bradgrantham/alice3cv/ColecoHat2/kicad/ColecoHat2.kicad_pcb

## KiCad design ColecoHat2/kicad/ColecoHat2.kicad_pcb (2018-12-31)

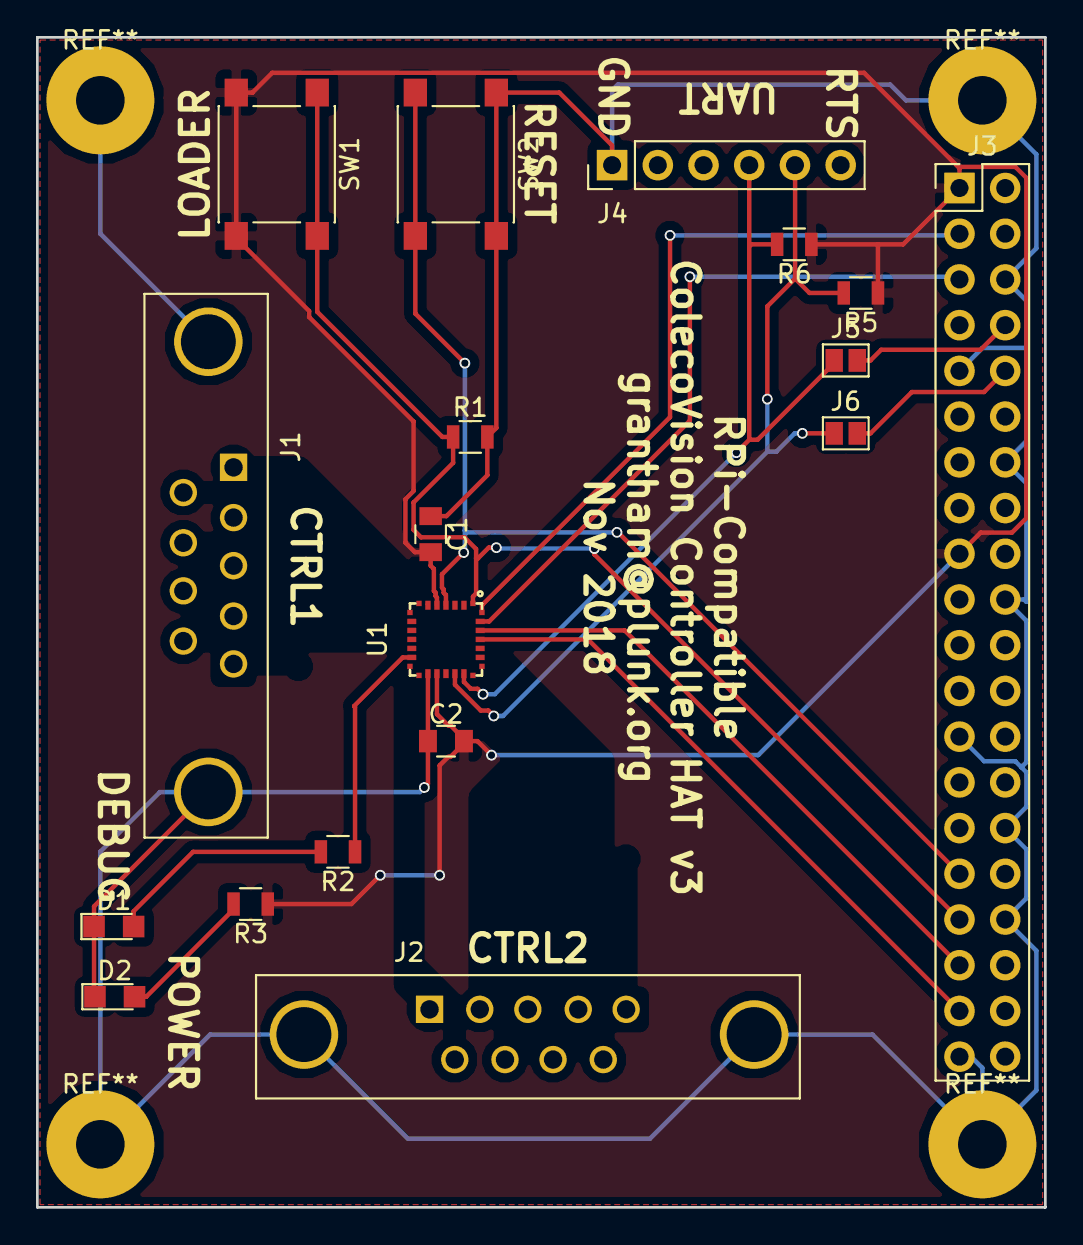
[picture p1: board ColecoHat2.kicad_pcb from above]

Board: 2 copper layers, 56.0 x 65.0 mm, 18 parts (0 on the bottom side), 31 nets.

Parts:
C1, C2: 100nF; C_0805
D1: DEBUG; LED_0805
D2: POWER; LED_0805
J1: CTRL1; DB9MD
J2: CTRL2; DB9MD
J3: PI_HEADER; Pin_Header_Straight_2x20_Pitch2.54mm
J4: CONN_01X06; Pin_Header_Straight_1x06_Pitch2.54mm
J5, J6: GS2
R1: 10k; R_0805
R2: 470; R_0805
R3: 1K; R_0805
R5, R6: 100k; R_0805
SW1: BOOTLOADER; SW_SPST_PTS645
SW2: RESET; SW_SPST_PTS645
U1: STM32L011G4U6; UFQFPN-28

Connections:
+3V3: C1.2, C2.2, J3.1, J3.17, R3.1, R5.1, R6.1, SW1.2, U1.5, U1.17
BOOTLOADER: J3.33, R1.1, SW1.1, U1.1
DEBUG_GPIO: J3.37, U1.25
DEBUG_LED: R2.1, U1.13
E1: J1.4, U1.11
E2: J2.4, U1.23
FIRE1: J1.6, U1.7
FIRE2: J2.6, U1.15
GND: C1.1, C2.1, D1.1, D2.1, J1.0, J2.0, J3.6, J3.9, J3.14, J3.20, J3.25, J3.30, J3.34, J3.39, J4.1, R1.2, SW2.1, U1.16
I2C1_SCL: J3.5, U1.27
I2C1_SDA: J3.3, U1.28
IRQ: J3.35, U1.26
N1: J1.1, U1.6
N2: J2.1, U1.14
NRST: J3.31, SW2.2, U1.4
unnamed: D1.2, R2.2
unnamed: D2.2, R3.2
unnamed: J3.8, J5.2
unnamed: J3.10, J6.2
QUADA1: J1.7, U1.9
QUADA2: J2.7, U1.21
QUADB1: J1.9, U1.12
QUADB2: J2.9, U1.24
S1: J1.2, U1.8
S2: J2.2, U1.18
SELECT_JOYSTICK: J1.8, J2.8, U1.2
SELECT_KEYPAD: J1.5, J2.5, U1.3
USART1_RX: J4.4, J5.1, R6.2, U1.20
USART1_TX: J4.5, J6.1, R5.2, U1.19
W1: J1.3, U1.10
W2: J2.3, U1.22
