bradgrantham/alice3cv/ColecoHat2/firmware/uart.c

#include <stm32l0xx_hal.h>
#include "defs.h"
#include "uart.h"
#include "stm32l0xx_ll_bus.h"
#include "stm32l0xx_ll_rcc.h"
// #include "stm32l0xx_ll_system.h"
// #include "stm32l0xx_ll_utils.h"
// #include "stm32l0xx_ll_cortex.h"
// #include "stm32l0xx_ll_exti.h"
//#include "stm32l0xx_ll_pwr.h"
#include "stm32l0xx_ll_gpio.h"
#include "stm32l0xx_ll_usart.h"

/*--------------------------------------------------------------------------*/
/* USART - serial comms ----------------------------------------------------*/

void SERIAL_send_one_char(char c)
{
    /* Wait for TXE flag to be raised */
    while (!LL_USART_IsActiveFlag_TXE(USART2));

    LL_USART_ClearFlag_TC(USART2); 

    /* Write character in Transmit Data register.
       TXE flag is cleared by writing data in TDR register */
    LL_USART_TransmitData8(USART2, c);

    /* Wait for TC flag to be raised for last char */
    while (!LL_USART_IsActiveFlag_TC(USART2));
}

void HAL_UART_ErrorCallback(UART_HandleTypeDef *huart)
{
    panic();
}

/**
  * @brief  This function configures USART2 Instance.
  * @note   This function is used to :
  *         -1- Enable GPIO clock and configures the USART pins.
  *         -2- Enable the USART peripheral clock and clock source.
  *         -3- Configure USART functional parameters.
  *         -4- Enable USART.
  * @note   Peripheral configuration is minimal configuration from reset values.
  *         Thus, some useless LL unitary functions calls below are provided as
  *         commented examples - setting is default configuration from reset.
  * @param  None
  * @retval None
  */
void SERIAL_init(void)
{
  /* (1) Enable GPIO clock and configures the USART pins *********************/

  /* Enable the peripheral clock of GPIO Port */
  LL_IOP_GRP1_EnableClock(LL_IOP_GRP1_PERIPH_GPIOA);

  /* Configure Tx Pin as : Alternate function, High Speed, Push pull, Pull up */
  LL_GPIO_SetPinMode(GPIOA, GPIO_PIN_9, LL_GPIO_MODE_ALTERNATE);
  LL_GPIO_SetAFPin_8_15(GPIOA, LL_GPIO_PIN_9, LL_GPIO_AF_4);
  LL_GPIO_SetPinSpeed(GPIOA, GPIO_PIN_9, LL_GPIO_SPEED_FREQ_HIGH);
  LL_GPIO_SetPinOutputType(GPIOA, GPIO_PIN_9, LL_GPIO_OUTPUT_PUSHPULL);
  LL_GPIO_SetPinPull(GPIOA, GPIO_PIN_9, LL_GPIO_PULL_UP);

  /* Configure Rx Pin as : Alternate function, High Speed, Push pull, Pull up */
  LL_GPIO_SetPinMode(GPIOA, GPIO_PIN_10, LL_GPIO_MODE_ALTERNATE);
  LL_GPIO_SetAFPin_8_15(GPIOA, LL_GPIO_PIN_10, LL_GPIO_AF_4);
  LL_GPIO_SetPinSpeed(GPIOA, GPIO_PIN_10, LL_GPIO_SPEED_FREQ_HIGH);
  LL_GPIO_SetPinOutputType(GPIOA, GPIO_PIN_10, LL_GPIO_OUTPUT_PUSHPULL);
  LL_GPIO_SetPinPull(GPIOA, GPIO_PIN_10, LL_GPIO_PULL_UP);

  /* (2) Enable USART peripheral clock and clock source ***********************/
  LL_APB1_GRP1_EnableClock(LL_APB1_GRP1_PERIPH_USART2);

  /* Set clock source */
  LL_RCC_SetUSARTClockSource(LL_RCC_USART2_CLKSOURCE_PCLK1);

  /* (3) Configure USART functional parameters ********************************/
  
  /* Disable USART prior modifying configuration registers */
  /* Note: Commented as corresponding to Reset value */
  // LL_USART_Disable(USART2);

  /* TX/RX direction */
  LL_USART_SetTransferDirection(USART2, LL_USART_DIRECTION_TX_RX);

  /* 8 data bit, 1 start bit, 1 stop bit, no parity */
  LL_USART_ConfigCharacter(USART2, LL_USART_DATAWIDTH_8B, LL_USART_PARITY_NONE, LL_USART_STOPBITS_1);

  /* No Hardware Flow control */
  /* Reset value is LL_USART_HWCONTROL_NONE */
  // LL_USART_SetHWFlowCtrl(USART2, LL_USART_HWCONTROL_NONE);

  /* Oversampling by 16 */
  /* Reset value is LL_USART_OVERSAMPLING_16 */
  // LL_USART_SetOverSampling(USART2, LL_USART_OVERSAMPLING_16);

  /* Set Baudrate to 115200 using APB frequency set to 16000000 Hz */
  /* Frequency available for USART peripheral can also be calculated through LL RCC macro */
  /* Ex :
      Periphclk = LL_RCC_GetUSARTClockFreq(Instance); or LL_RCC_GetUARTClockFreq(Instance); depending on USART/UART instance
  
      In this example, Peripheral Clock is expected to be equal to 16000000 Hz => equal to SystemCoreClock
  */
  LL_USART_SetBaudRate(USART2, SystemCoreClock, LL_USART_OVERSAMPLING_16, 115200); 

  /* (4) Enable USART *********************************************************/
  LL_USART_Enable(USART2);

  /* Polling USART initialisation */
  while((!(LL_USART_IsActiveFlag_TEACK(USART2))) || (!(LL_USART_IsActiveFlag_REACK(USART2))))
  { 
  }
}
