bradgrantham/alice3cv/ColecoHat2/firmware/delay.h

#ifndef __DELAY_H__
#define __DELAY_H__

#include <stdio.h>

#ifdef __cplusplus
extern "C" {
#endif

void delay_ms(int ms);
void delay_us(uint32_t us);
void delay_100ms(unsigned char count);
void delay_init(void) ;

#ifdef __cplusplus
}
#endif

#endif /* __DELAY_H__ */
