bradgrantham/alice3cv/ColecoHat2/firmware/leds.h

#ifndef __LEDS_H__
#define __LEDS_H__

#ifdef __cplusplus
extern "C" {
#endif

void LED_set_panic(int on);
void LED_beat_heart();
void LED_set_info(int on);
void LED_init();

#ifdef __cplusplus
}
#endif

#endif /* __LEDS_H__ */
