bradgrantham/alice3cv/(commit log)

2018-09-29 Initial commit
    ColecoHat HAT for CV controllers
    dostuff.cpp makes binary images into bitmaps
    [ColecoHat.kicad_pcb, ColecoHat.sch]
2018-09-29 Rename KiCAD files for 2nd version of HAT
    [ColecoHat2.kicad_pcb, ColecoHat2.sch]
2018-10-01 update to PCB and BOM fields
    [ColecoHat2.kicad_pcb, ColecoHat2.sch]
2018-10-04 add pull-ups for UART
    [ColecoHat2.kicad_pcb, ColecoHat2.sch]
2018-10-27 add STM32L0 STM32L011G4U6 component
2018-10-27 move KiCAD bits into kicad subdirectory
    [ColecoHat2.kicad_pcb, ColecoHat2.sch]
2018-10-28 add initial bits for ARM firmware
2018-11-04 print whichever direction or FIRE1 is being pushed
    Add synchronous UART support
    Shrink heap to 0 (to fit .data and .bss and stack)
    Set and read joystick pins
2018-11-25 add i2c initial stabs
2018-11-25 quiet i2c debugging
2018-11-25 remove some i2c dead code
2018-11-25 pass controllers over i2c
2018-12-31 add larger STM32L041K6U6 component
